857456/Remota_TCC_UCL/Figura 2.png

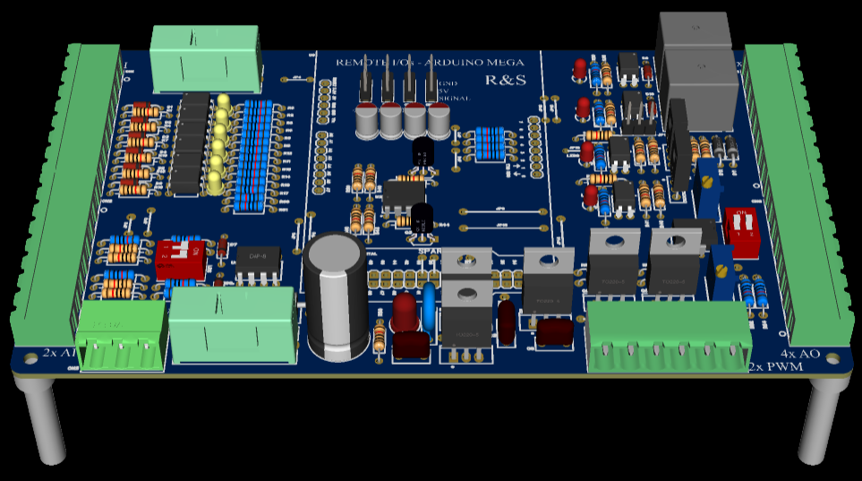
Figura 2.png
