857456/Remota_TCC_UCL/Figura 1.png

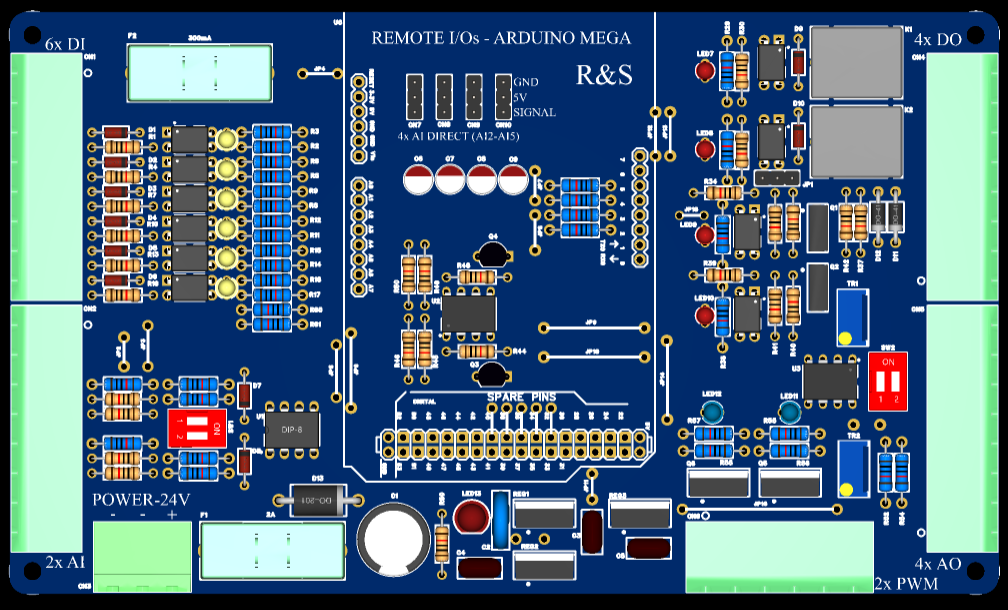
Figura 1.png
