857456/Remota_TCC_UCL/README.md

Projeto executado utilizando o software EASYEDA PRO para criação do diagrama eletrico e confecção da PCI.
