857456/Remota_TCC_UCL/Figura 3.png

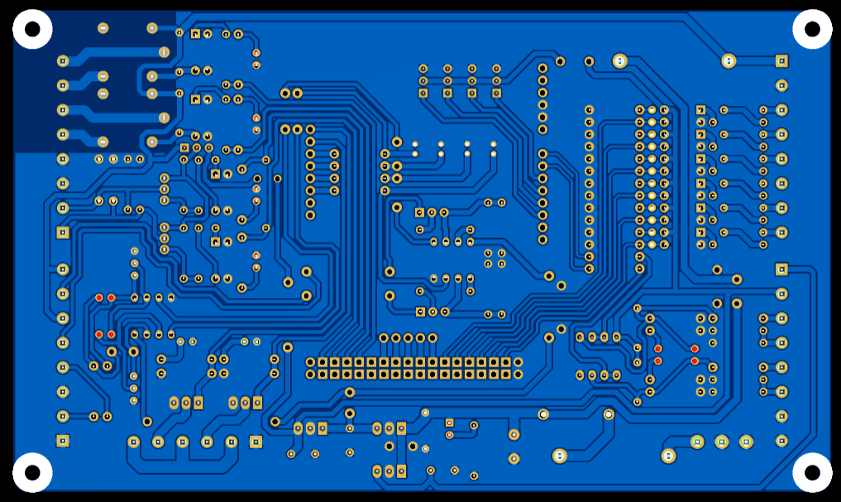
Figura 3.png
