857456/Remota_TCC_UCL/Figura 4.png

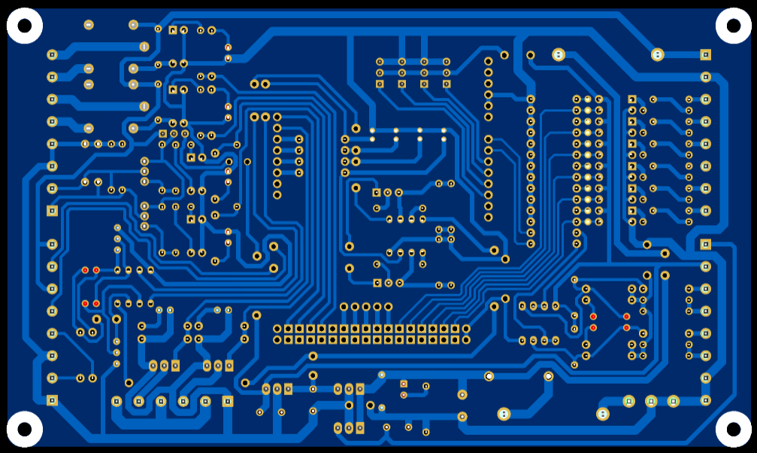
Figura 4.png
