857456/Remota_TCC_UCL/Diagrama_Remote_IO.pdf

# ENTRADAS DIGITAIS

# SAIDAS PWM MOTOR SAIDAS ANALOG. CORRENTE

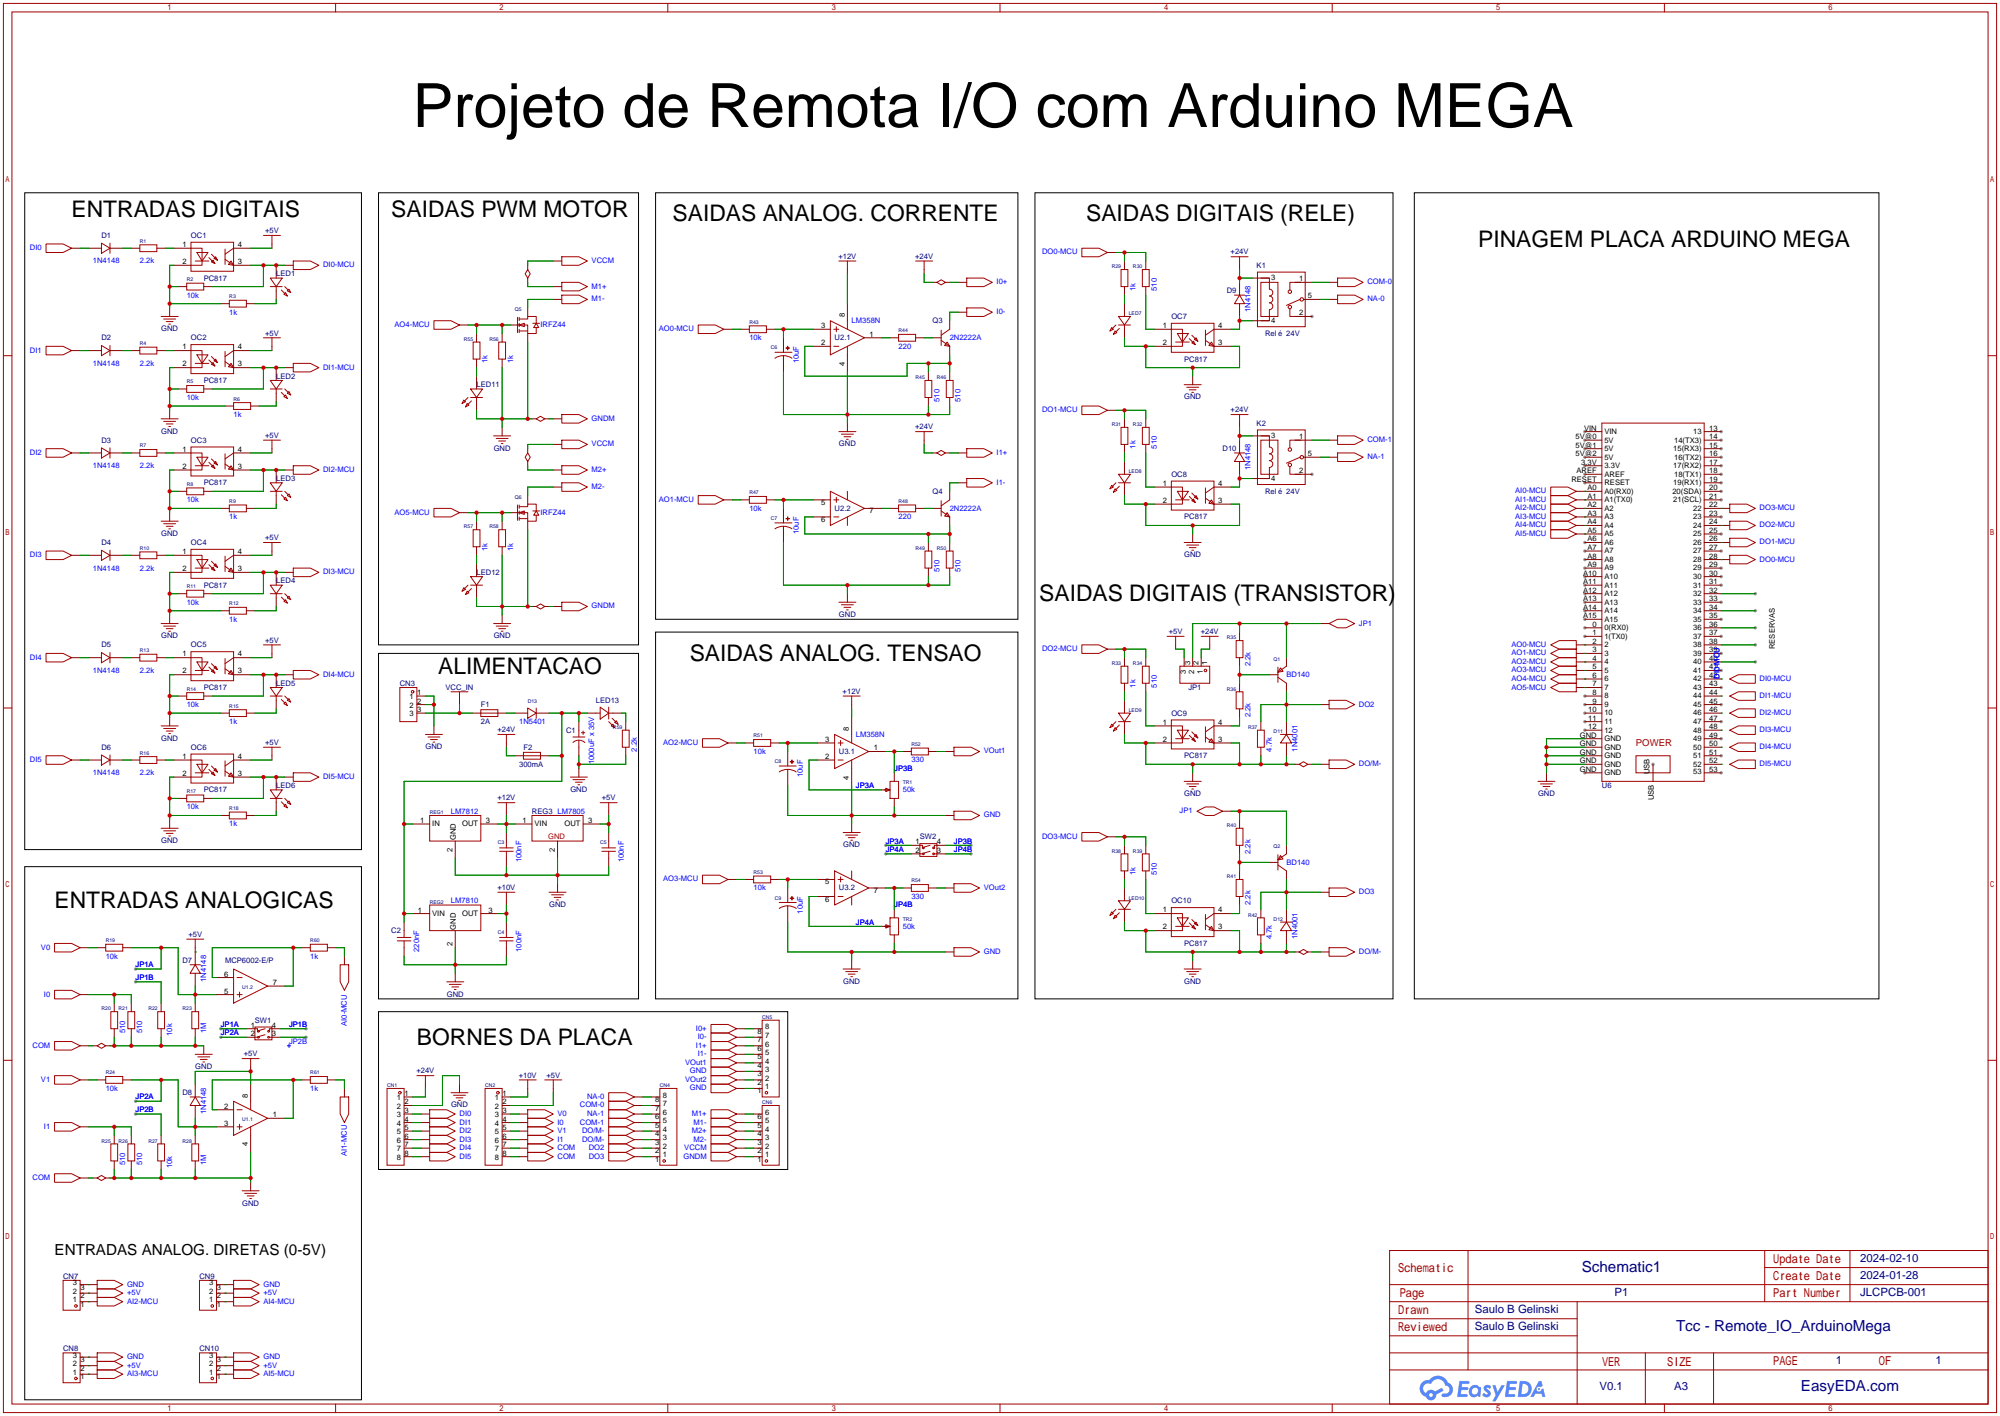
[picture p36: page 1]

Projeto de Remota I/O com Arduino MEGA

PINAGEM PLACA ARDUINO MEGA
