857456/Remota_TCC_UCL/Arquivos para imprimir/PCI_Remote_IO_Bottom_Solder_Mask_INV.pdf

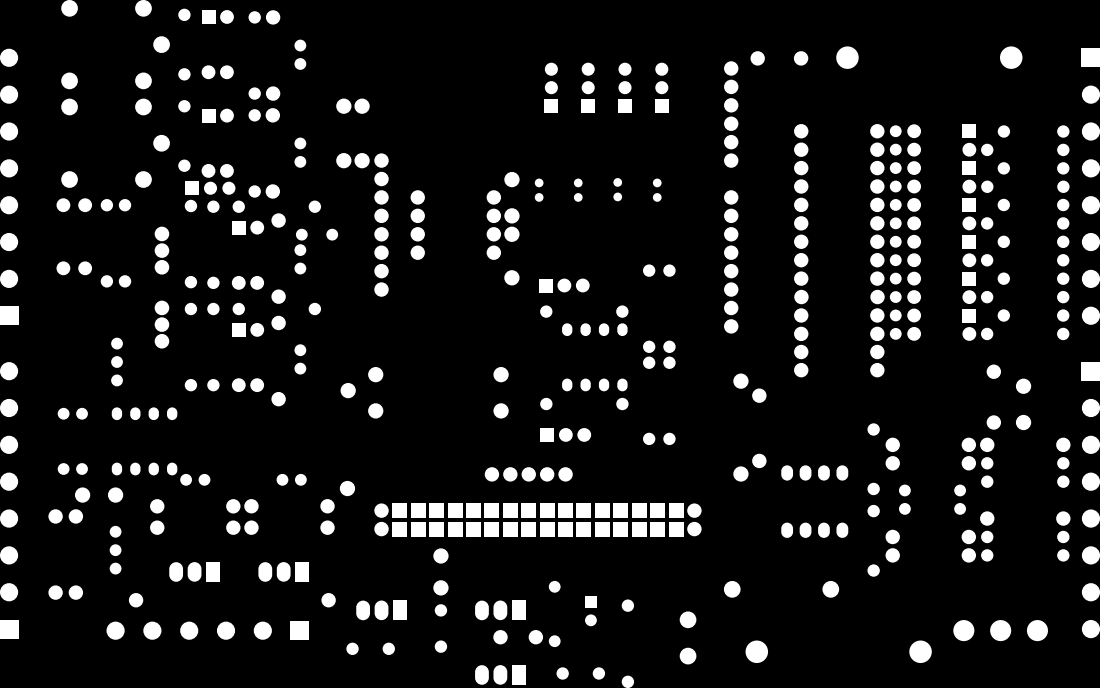
[picture p37: page 1]
