857456/Remota_TCC_UCL/Arquivos para imprimir/PCI_Remote_IO_Bottom2_Copper.pdf

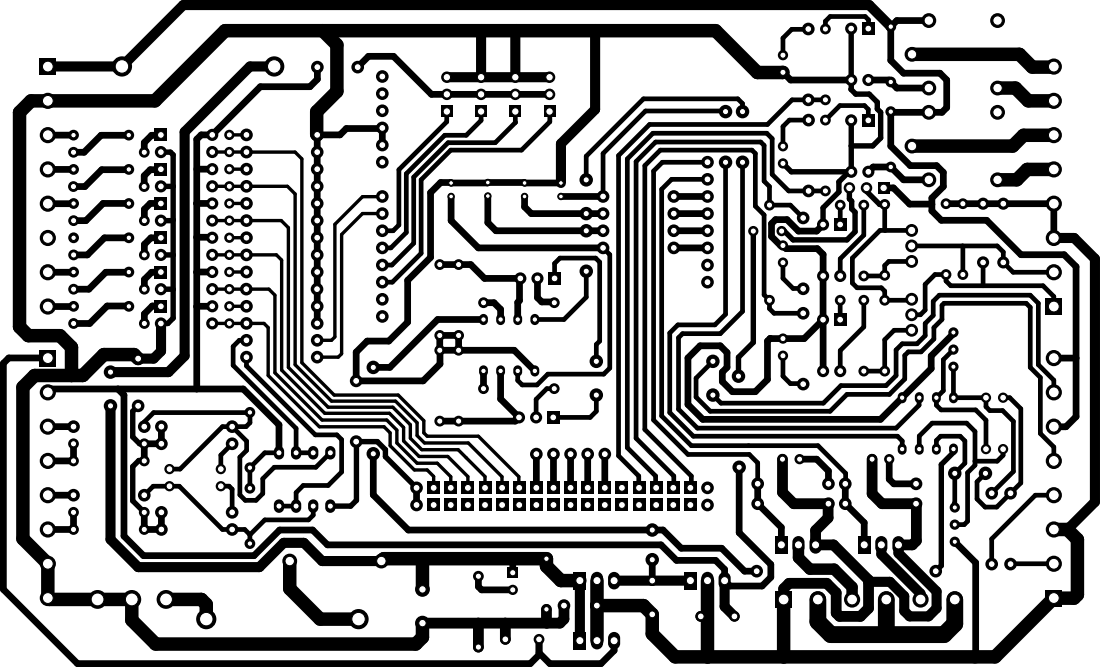
[picture p38: page 1]
