857456/Remota_TCC_UCL/Arquivos para imprimir/PCI_Remote_IO_Bottom_Copper.pdf

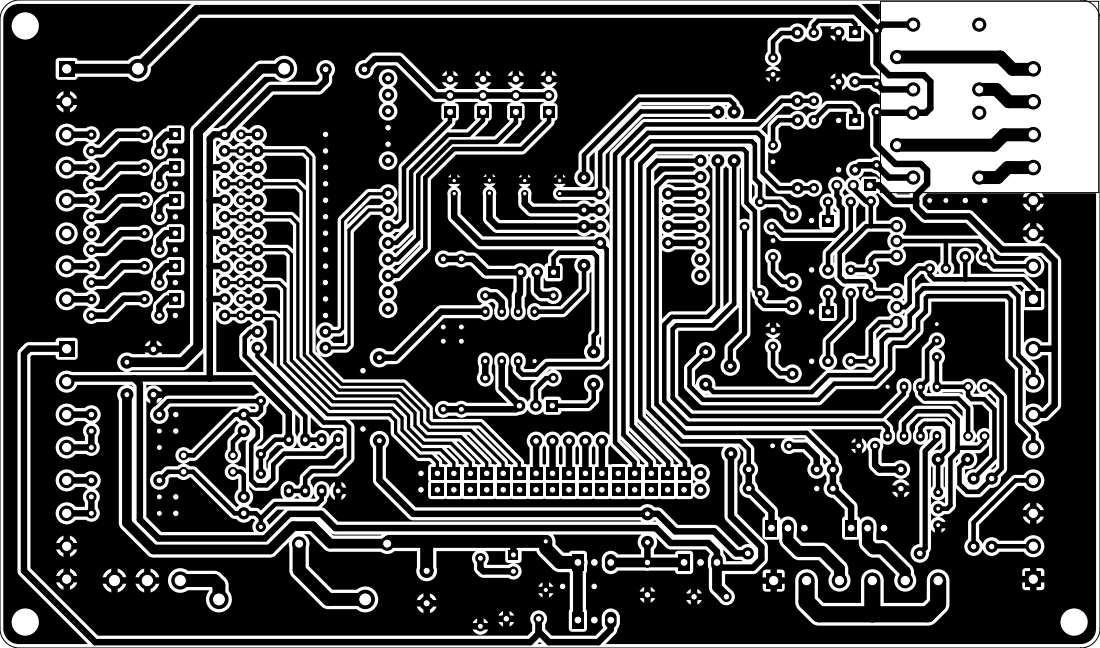
[picture p39: page 1]
