857456/Remota_TCC_UCL/Arquivos para imprimir/PCI_Remote_IO_Bottom_Copper2_INV.pdf

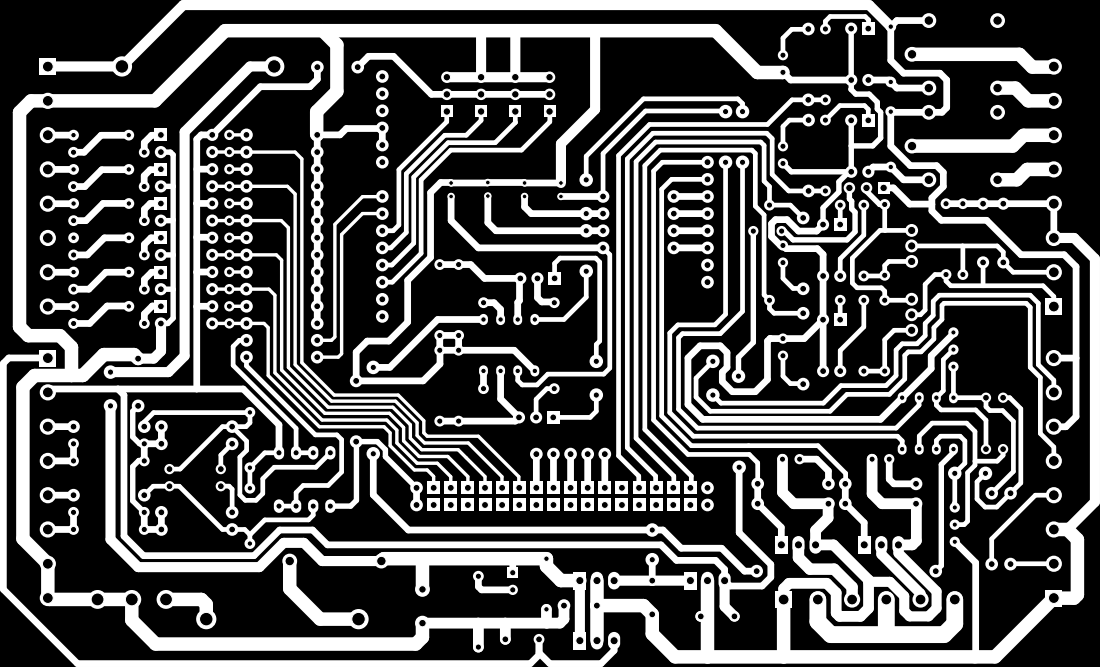
[picture p40: page 1]
