857456/Remota_TCC_UCL/Arquivos para imprimir/PCI_Remote_IO_Bottom_Copper_INV.pdf

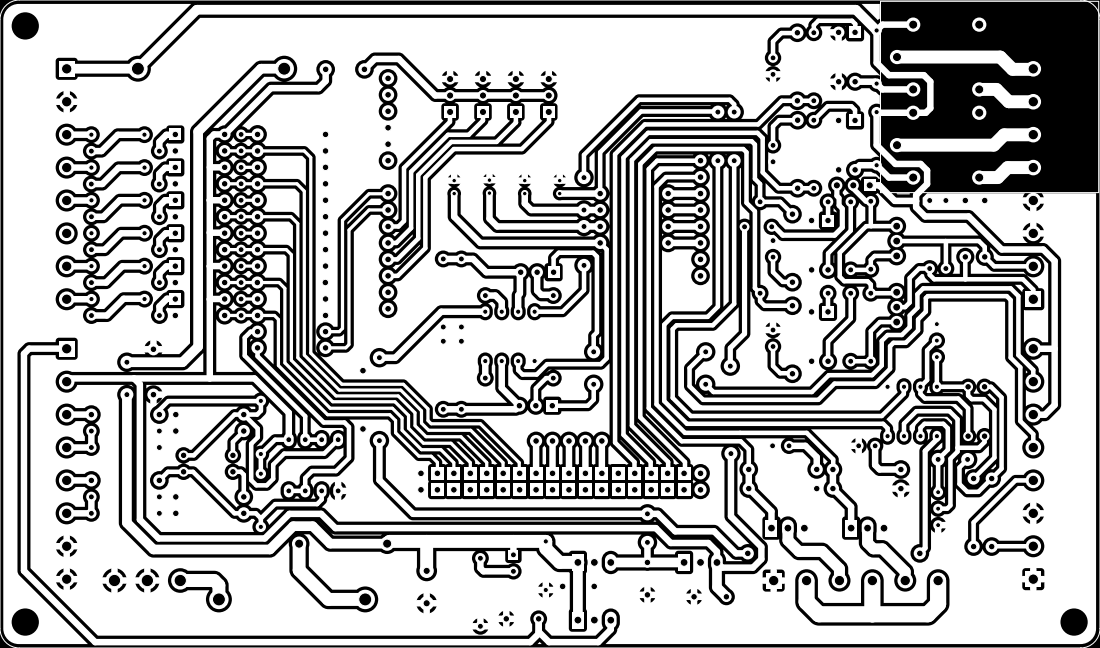
[picture p41: page 1]
