857456/Remota_TCC_UCL/Arquivos para imprimir/PCI_Remote_IO_Top_Silk_INV_MIRR.pdf

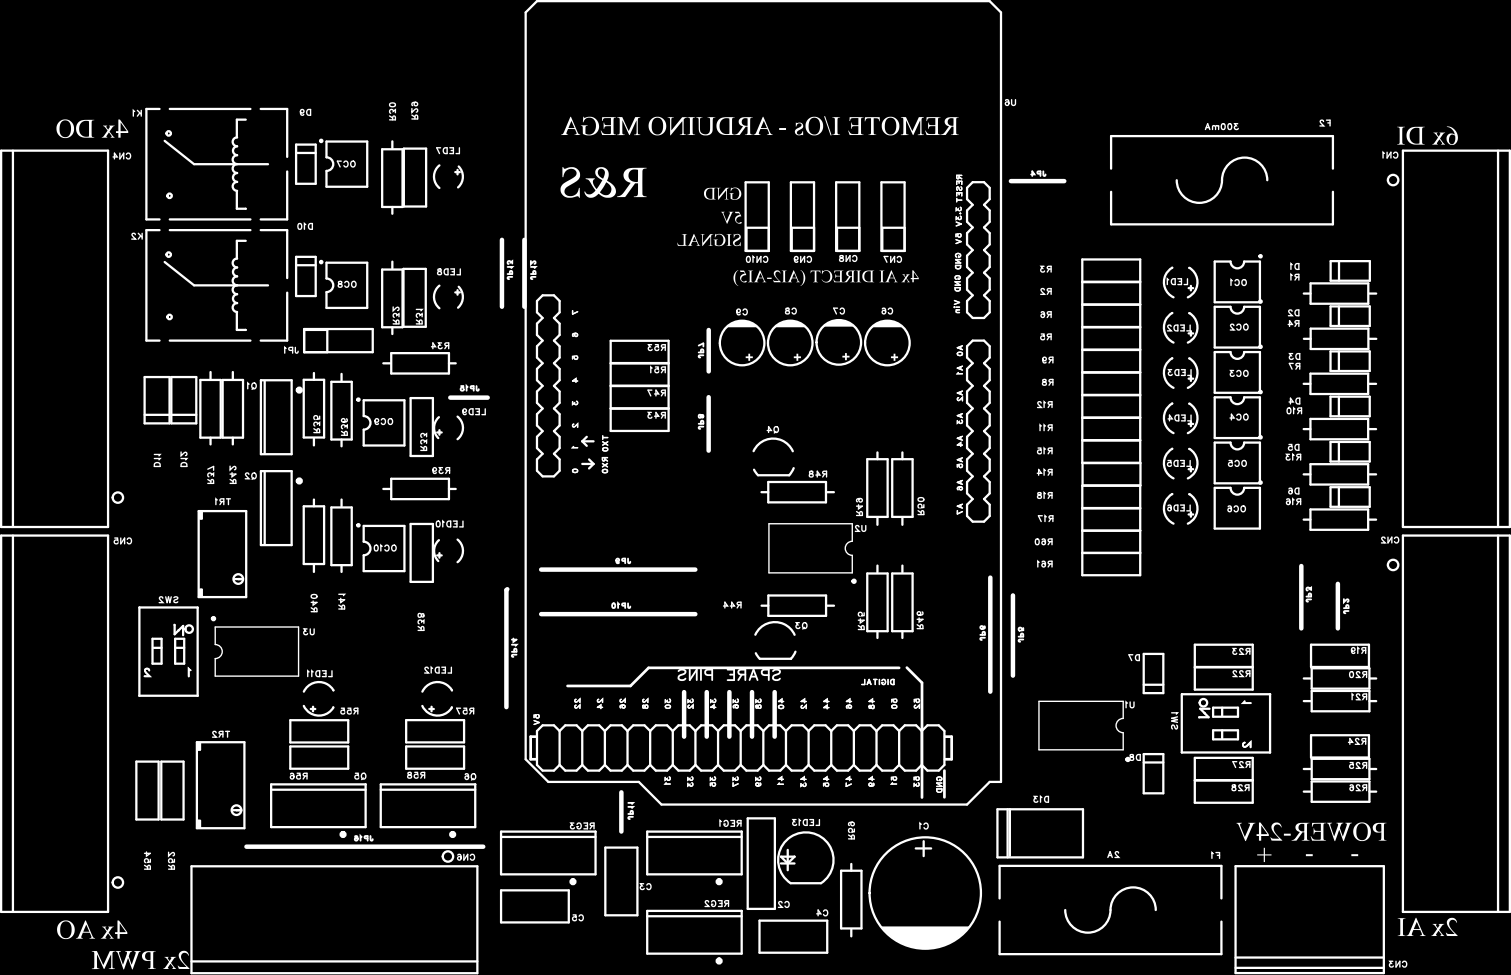
[picture p42: page 1]
