857456/Remota_TCC_UCL/Arquivos para imprimir/PCI_Remote_IO_Top_Silk_MIRR.pdf

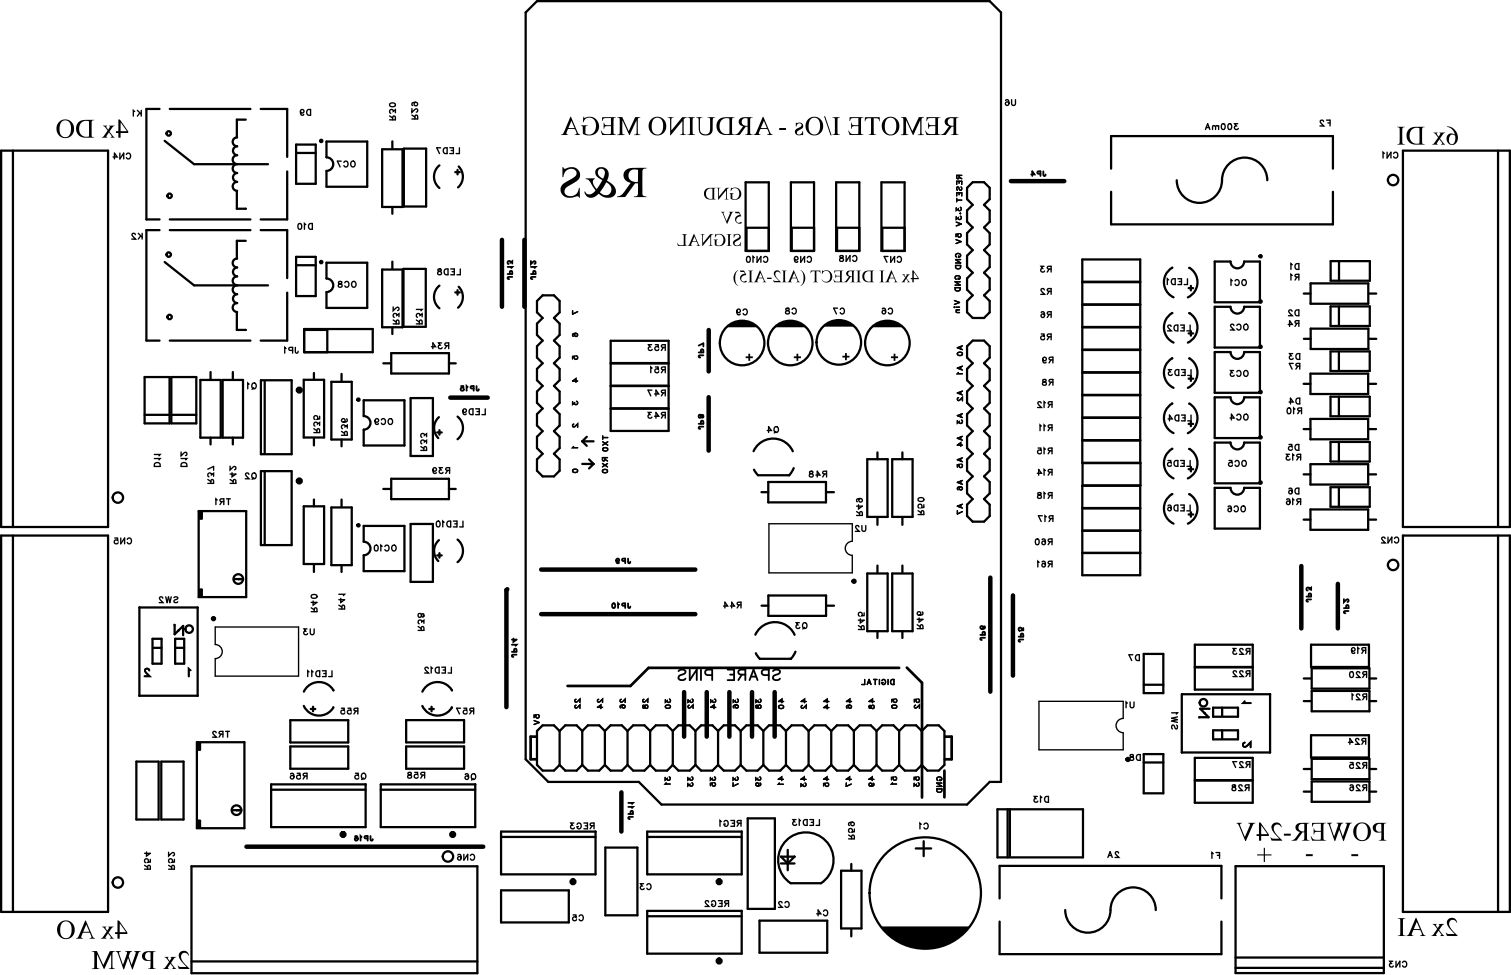
[picture p43: page 1]
