857456/Remota_TCC_UCL/(commit log)

2024-02-06 Projeto circuito impresso
    Commit_1
2024-02-10 Projeto Completo no EasyEda com 2 opções de PCI
